Aman918an/round-robin-arbiter/asics/final/6_final.v

module round_robin_arbiter (clk,
    rst,
    grant,
    request);
 input clk;
 input rst;
 output [3:0] grant;
 input [3:0] request;

 wire _000_;
 wire _001_;
 wire _002_;
 wire _003_;
 wire _004_;
 wire _005_;
 wire _006_;
 wire _007_;
 wire _008_;
 wire _009_;
 wire _010_;
 wire _011_;
 wire _012_;
 wire _013_;
 wire _014_;
 wire _015_;
 wire _016_;
 wire _017_;
 wire _019_;
 wire _020_;
 wire _021_;
 wire _022_;
 wire _023_;
 wire _024_;
 wire _025_;
 wire _026_;
 wire _027_;
 wire _028_;
 wire _029_;
 wire _030_;
 wire _031_;
 wire _032_;
 wire _033_;
 wire _034_;
 wire _035_;
 wire _036_;
 wire _037_;
 wire _038_;
 wire _039_;
 wire _040_;
 wire _041_;
 wire _042_;
 wire _043_;
 wire _044_;
 wire _045_;
 wire _046_;
 wire _047_;
 wire _048_;
 wire _049_;
 wire _050_;
 wire _051_;
 wire _052_;
 wire _053_;
 wire _054_;
 wire _055_;
 wire _056_;
 wire _057_;
 wire _058_;
 wire _059_;
 wire _060_;
 wire _061_;
 wire _062_;
 wire _063_;
 wire _064_;
 wire _065_;
 wire _066_;
 wire _067_;
 wire _068_;
 wire _069_;
 wire _070_;
 wire _071_;
 wire _072_;
 wire _073_;
 wire _074_;
 wire _075_;
 wire _076_;
 wire _077_;
 wire _078_;
 wire _079_;
 wire _080_;
 wire _081_;
 wire _082_;
 wire _083_;
 wire _084_;
 wire _085_;
 wire _086_;
 wire _087_;
 wire _088_;
 wire _089_;
 wire _090_;
 wire _091_;
 wire _092_;
 wire _093_;
 wire _094_;
 wire _095_;
 wire \actual_requester[0] ;
 wire net6;
 wire net7;
 wire net8;
 wire net9;
 wire \pointer[0] ;
 wire \pointer[1] ;
 wire net1;
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
    .CO(_005_),
    .S(_006_));
 HA_X1 _186_ (.A(\actual_requester[0] ),
    .B(_000_),
    .CO(_093_),
    .S(_004_));
 HA_X1 _187_ (.A(\pointer[0] ),
    .B(_000_),
    .CO(_007_),
    .S(_094_));
 HA_X1 _188_ (.A(\pointer[0] ),
    .B(\pointer[1] ),
    .CO(_008_),
    .S(_095_));
 CLKBUF_X2 clkbuf_0_clk (.A(clk),
    .Z(clknet_0_clk));
 CLKBUF_X2 clkbuf_1_0__f_clk (.A(clknet_0_clk),
    .Z(clknet_1_0__leaf_clk));
 CLKBUF_X2 clkbuf_1_1__f_clk (.A(clknet_0_clk),
    .Z(clknet_1_1__leaf_clk));
 BUF_X1 input1 (.A(request[0]),
    .Z(net1));
 BUF_X1 input2 (.A(request[1]),
    .Z(net2));
 BUF_X1 input3 (.A(request[2]),
    .Z(net3));
 BUF_X1 input4 (.A(request[3]),
    .Z(net4));
 BUF_X1 input5 (.A(rst),
    .Z(net5));
 BUF_X1 output6 (.A(net6),
    .Z(grant[0]));
 BUF_X1 output7 (.A(net7),
    .Z(grant[1]));
 BUF_X1 output8 (.A(net8),
    .Z(grant[2]));
 BUF_X1 output9 (.A(net9),
    .Z(grant[3]));
 DFF_X1 \pointer[0]$_SDFFE_PP0P_  (.D(_009_),
    .CK(clknet_1_0__leaf_clk),
    .Q(\pointer[0] ),
    .QN(\actual_requester[0] ));
 DFF_X1 \pointer[1]$_SDFFE_PP0P_  (.D(_010_),
    .CK(clknet_1_1__leaf_clk),
    .Q(\pointer[1] ),
    .QN(_000_));
endmodule
