Aman918an/round-robin-arbiter/(commit log)

2026-09-10 Enhance README with project details and structure
    Added detailed project description, current status, design overview, repository structure, verification approach, tools, and roadmap to README.
2026-09-12 Implement tracking for grant and pointer state coverage
    Added logic to track which grants and pointer states have been seen during test execution. Enhanced reporting to verify coverage of all requesters and pointer states.
2026-09-13 Integrate assertions and enhance test case in tb.sv
    Added assertions for the round robin arbiter and updated the test case to validate expected behavior.
2026-09-13 Add stronger SVA properties and corner-case checks
2026-09-15 Enhance README with synthesis and timing details
    Updated README to reflect completion of synthesis, static timing analysis, and power estimation. Added sections for synthesis, timing, and power results with detailed metrics.
2026-11-03 Add grid strategy for power distribution network
2026-11-03 Create global place report with timing and power data
    Added global place report with timing and power analysis.
2026-11-03 Add timing report for resizer analysis
    Added resizer report with timing analysis including path delays, slack, and power consumption metrics.
2026-11-03 Add final CTS report for timing and power analysis
    Added final CTS report with timing and power analysis.
2026-11-03 Add global route report with performance metrics
    Added global route report with various metrics including TNS, WNS, worst slack, and power consumption.
2026-11-03 Add finish report with timing and power analysis
    Added a detailed finish report including timing, slack, and power analysis.
